AnnaBesk/heater/initial_corpe/heater_up (1).STL

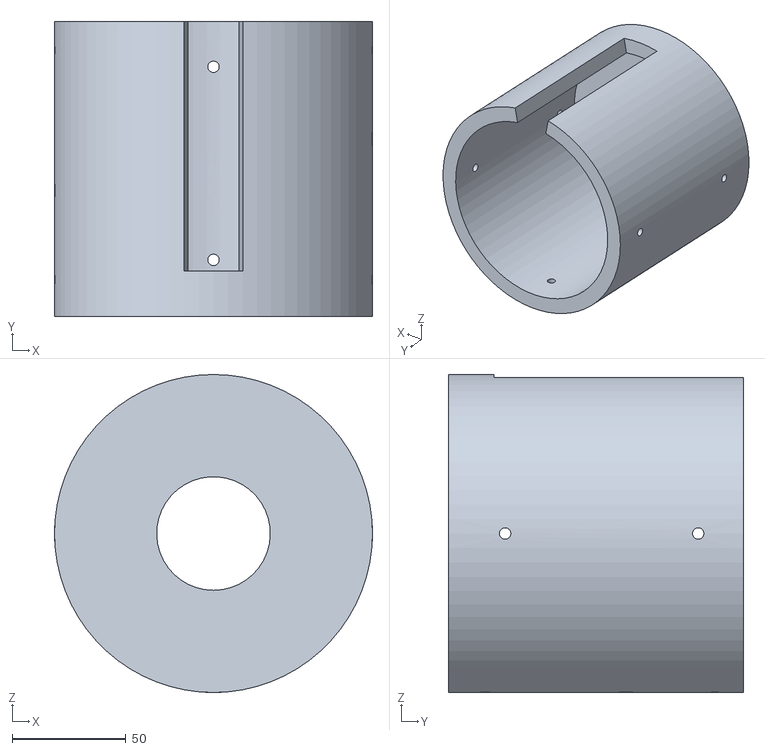
[picture p5: CAD file, 2024-12-18]
initial_corpe/heater_up (1).STL
140.0 x 130.0 x 140.0
