AnnaBesk/heater/initial_corpe/heater_bot (1).STL

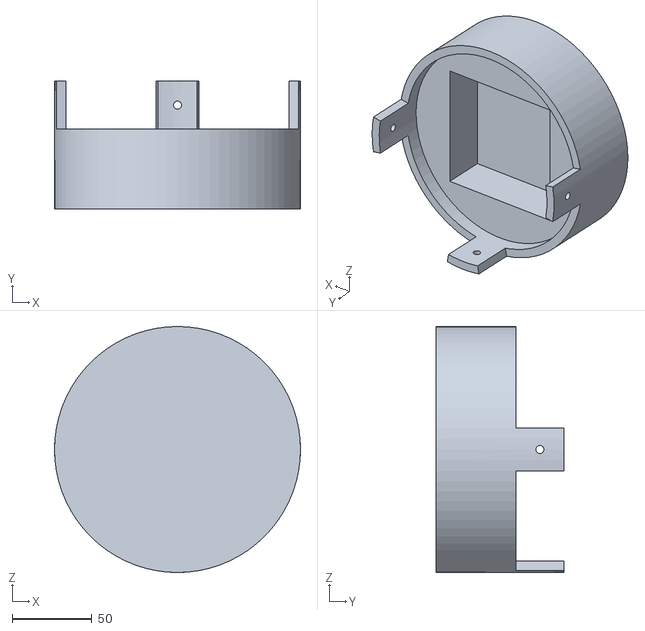
[picture p6: CAD file, 2024-12-18]
initial_corpe/heater_bot (1).STL
154.0 x 80.0 x 154.0
