AnnaBesk/heater/last_version_corpe/нагреватель низ.SLDPRT

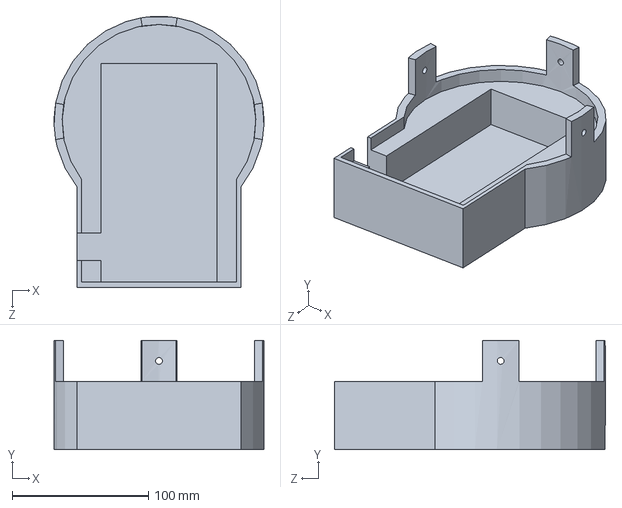
[picture p7: CAD file, 2024-12-18]
last_version_corpe/нагреватель низ.SLDPRT
154.0 x 80.0 x 199.0 mm
