AnnaBesk/heater/(list of files, cad)

Other CAD files:
last_version_corpe/Нагреватель верх.SLDPRT
last_version_corpe/Нагреватель верх.STL
last_version_corpe/нагреватель низ.STL
