AnnaBesk/heater/(commit log)

2024-12-18 Файлы из разработки
    [Нагреватель верх.SLDPRT, Нагреватель верх.STL, Сборка1 (1).SLDASM, нагреватель низ.SLDPRT, нагреватель низ.STL]
2024-12-18 Rename Нагреватель верх.SLDPRT to last_version_corpe/Нагреватель верх.SLDPRT
    [Нагреватель верх.SLDPRT]
2024-12-18 Rename Нагреватель верх.STL to last_version_corpe/Нагреватель верх.STL
    [Нагреватель верх.STL]
2024-12-18 Rename нагреватель низ.SLDPRT to last_version_corpe/нагреватель низ.SLDPRT
    [нагреватель низ.SLDPRT]
2024-12-18 Rename Сборка1 (1).SLDASM to last_version_corpe /Сборка1 (1).SLDASM
    [Сборка1 (1).SLDASM]
2024-12-18 Rename нагреватель низ.STL to last_version_corpe/нагреватель низ.STL
    [нагреватель низ.STL]
